philipfei/NALA/firmware/prayer.jpeg

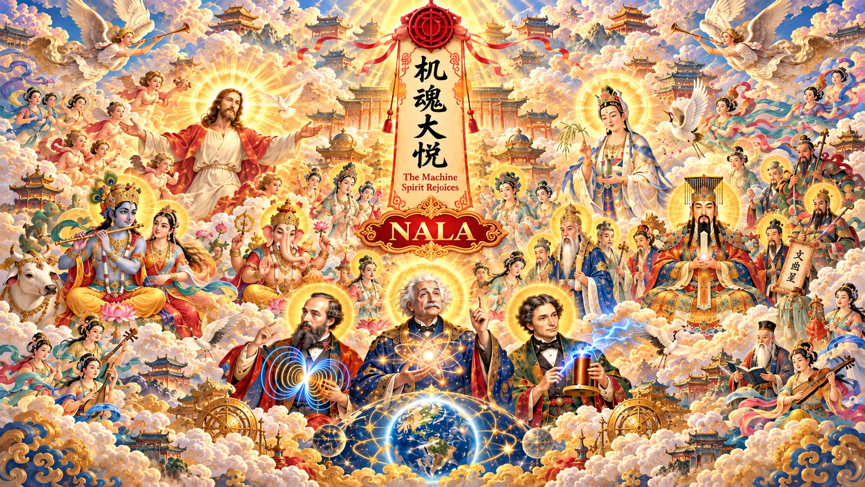
firmware/prayer.jpeg
