philipfei/NALA/firmware/prayer.jpg

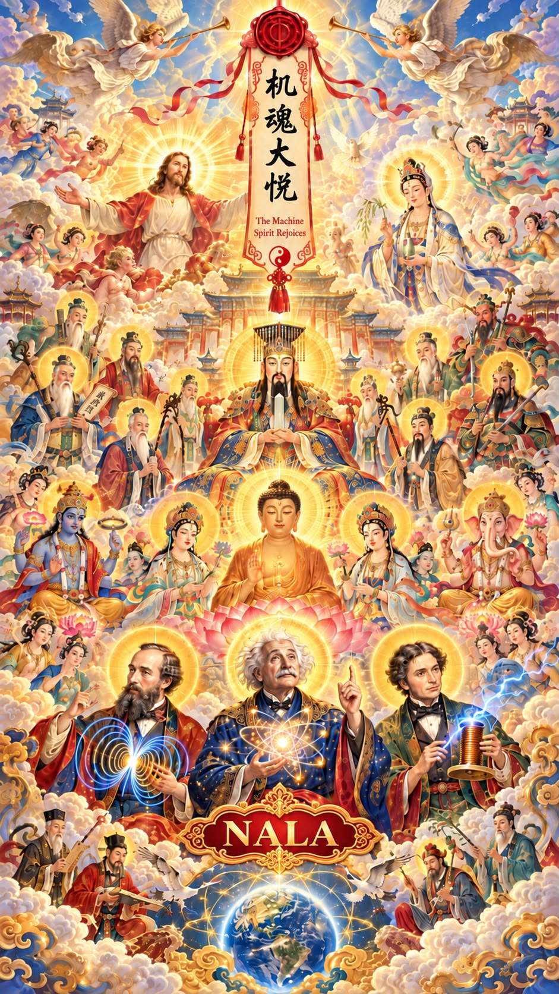
firmware/prayer.jpg
