philipfei/NALA/src/nala_base/nala_base/kinematics.py

"""Mecanum chassis math (no ROS): wheel speed limit and odometry."""

import math

from nala_base.mcu_protocol import SCALE


def raise_wheel_speed(vx, vy, wz, k, min_wheel_speed):
    """Raise a slow body speed command so that its fastest wheel is at least min_wheel_speed.

    The mirror of limit_wheel_speed: vx, vy and wz are scaled up by the same factor, so the
    direction is kept. Reason: a stalled wheel gets at most FF + kp x target + i_limit PWM in
    the firmware, so a slow target can leave a wheel standing (most often turning on the spot).
    A command that is zero in the MCU protocol (all values round to 0 mm/s, 0 mrad/s) stays
    exactly zero, so float noise never starts the robot.
    k: half track width + half wheelbase (m). min_wheel_speed: wheel rim speed (m/s).
    """
    if all(round(value * SCALE) == 0 for value in (vx, vy, wz)):
        return 0.0, 0.0, 0.0
    peak = abs(vx) + abs(vy) + k * abs(wz)
    if peak < min_wheel_speed:
        scale = min_wheel_speed / peak
        vx *= scale
        vy *= scale
        wz *= scale
    return vx, vy, wz


def limit_wheel_speed(vx, vy, wz, k, max_wheel_speed):
    """Limit a body speed command so that no wheel is faster than max_wheel_speed.

    The wheel rim speeds of a mecanum base are vx +- vy +- k*wz (all 4 sign pairs),
    so the fastest wheel is |vx| + |vy| + k*|wz|. If that is too fast, vx, vy and wz are
    scaled down by the same factor: the path keeps its shape, only slower.
    k: half track width + half wheelbase (m). max_wheel_speed: wheel rim speed (m/s).
    """
    peak = abs(vx) + abs(vy) + k * abs(wz)
    if peak > max_wheel_speed:
        scale = max_wheel_speed / peak
        vx *= scale
        vy *= scale
        wz *= scale
    return vx, vy, wz


def wheels_to_body(m1, m2, m3, m4, radius, k):
    """Wheel speeds (rad/s) -> body speed (vx, vy, wz).

    Also works for movements: wheel angle changes (rad) -> body movement (dx, dy, dyaw).

    M1 front-left, M2 rear-left, M3 rear-right, M4 front-right. Positive = the wheel pushes forward.
    radius: wheel radius (m). k: half track width + half wheelbase (m).
    This is the inverse of the firmware kinematics (docs/mcu_protocol.md).
    """
    vx = radius / 4 * (m1 + m2 + m3 + m4)
    vy = radius / 4 * (-m1 + m2 - m3 + m4)
    wz = radius / (4 * k) * (-m1 - m2 + m3 + m4)
    return vx, vy, wz


def integrate_pose(x, y, yaw, vx, vy, wz, dt):
    """Move the pose (x, y, yaw) by the body speed (vx, vy, wz) for dt seconds.

    Uses the heading in the middle of the step, which is exact enough for small steps.
    """
    mid = yaw + wz * dt / 2
    x += (vx * math.cos(mid) - vy * math.sin(mid)) * dt
    y += (vx * math.sin(mid) + vy * math.cos(mid)) * dt
    yaw = math.atan2(math.sin(yaw + wz * dt), math.cos(yaw + wz * dt))
    return x, y, yaw
