philipfei/NALA/config/panel.yaml

# Touchscreen panel on the robot (nala_panel, app 3). Runs on the Pi, on the 7 inch screen (1024 x 600).
# Started by scripts/start_panel.sh (at boot, see scripts/setup_pi_screen.sh).
# Write decimal values with a point (2.0, not 2), or the node stops with a type error.
nala_panel:
  ros__parameters:
    maps_dir: maps                # map library, relative to the repo folder (app 2 saves maps there)
    fullscreen: true              # false: a normal window (on the PC)
    window_width: 1024            # px, Waveshare 7 inch HDMI LCD (C)
    window_height: 600            # px
    font_size: 13                 # pt
    button_height: 52             # px, big enough for a finger
    update_period: 0.3            # s, how often the screen shows new robot data while driving
    manual_period: 0.05           # s, how often a held arrow button sends its command (drive by hand)
    heatmap_width_m: 0.15         # m, readings are drawn this wide around the sensor track (display only; hotspots
                                  # use the exact cells)
    launch_stop_timeout: 20.0     # s, wait this long for app 3 to stop before it is killed
    preview_retry: 10.0           # s, ask app 3 for the plan check again if it has not come by then
    battery_period: 2.0           # s, the panel reads the battery voltage (INA219, config/battery.yaml) this often
    battery_samples: 10           # shown value = mean of the last readings (10 x 2 s = 20 s), so it does not jump
    hardware: true               # false: app 3 without base_node, battery, IMU, EKF and LiDAR driver (tools/sim)
