philipfei/NALA/coverage_tool/examples/map_ME_room1v4_nala.yaml

frame_id: map
map: examples/map_ME_room1v4.yaml
map_image_sha256: c2630cb1c1f60038c21bde62c76103a3ffc8df23effceb4ea6053b22c3474248
created: '2026-10-07T14:05:45'
start: [1.157, -1.875]
area_polygon: []
stats: {pattern: 'Boustrophedon cells, no wall loop (97 deg)', cost_total_s: 463.6501, cost_drive_s: 67.0491, cost_turn_s: 234.8788,
  cost_bend_s: 15.2118, edge_missed_m2: 0.0, cost_reverse_s: 100.0, cost_overlap_s: 61.7222, cost_missed_s: 0.0, sharp_turns: 78,
  hairpins: 10, overlap_m2: 22.22, missed_m2: 0.0, coverage_pct: 54.1929, coverage_of_reachable_pct: 100.0, area_m2: 17.8575,
  covered_m2: 9.6775, path_spacing_m: 1.08, overlap_pct: 10.0, regions: 1, rings: 0, loops: 0, working_length_m: 8.6359, connector_length_m: 11.4788,
  total_length_m: 20.1147, estimated_time_s: 301.9278, goals: 28, wall_segments: 0, spiral_segments: 0, lane_segments: 6,
  centre_line_segments: 6, gap_goals: 16, skipped_unreachable: 0, uncovered_reachable_cells: 0, uncovered_interior_cells: 0,
  planning_time_s: 123.1341, drive_stops: 26, drive_arcs: 11, drive_length_m: 14.5056, drive_lost_cells: 0, drive_unsafe_segments: 0,
  drive_min_arc_radius_m: 0.3242, drive_corners_planned: 110, drive_corners_kept: 49, footprint_hits: 0}
settings:
  geometry:
    robot_radius_m: 0.33
    coverage_disk_radius_m: 0.6
    sensor_offset_m: 0.26
    footprint_m:
    - [0.205, 0.18]
    - [0.205, -0.18]
    - [-0.205, -0.18]
    - [-0.205, 0.18]
    footprint_padding_m: 0.02
  spiral: {overlap_pct: 10.0, obstacle_mode: around, wall_side: right}
  strategy: {mode: auto, wall_loop_first: true}
  cost: {smooth_turn_deg: 20.0, bend_s_per_rad: 1.5, stop_penalty_s: 1.0, reverse_angle_deg: 150.0, reverse_penalty_s: 10.0,
    overlap_weight: 1.0, missed_weight: 10000.0, edge_band_m: 0.1, edge_missed_weight: 10000.0}
  planning: {max_segment_length_m: 2.0}
  motion: {linear_m_s: 0.3, angular_rad_s: 0.8}
  drive: {min_arc_radius_m: 0.2, spacing_m: 0.05, straight_deg: 1.0, max_corner_group: 8}
  optimizer: {search_time_s: 4.0, polish_time_s: 15.0, neighbours: 8}
poses:
- x: 1.157
  y: -1.875
  yaw: 2.7328
  orientation: {z: 0.979183, w: 0.202978}
  kind: transit
- x: 0.8924
  y: -1.7604
  yaw: 2.7328
  orientation: {z: 0.979183, w: 0.202978}
  kind: transit
- x: 0.857
  y: -1.725
  yaw: 2.35619
  orientation: {z: 0.92388, w: 0.382683}
  kind: aim
- x: 1.057
  y: -1.675
  yaw: 0.24498
  orientation: {z: 0.122183, w: 0.992508}
  kind: transit
- x: 1.1873
  y: -1.571
  yaw: 0.6738
  orientation: {z: 0.330564, w: 0.943784}
  kind: transit
- x: 1.207
  y: -1.525
  yaw: 1.1659
  orientation: {z: 0.550491, w: 0.834841}
  kind: aim
- x: 1.2099
  y: -1.5749
  yaw: -1.51204
  orientation: {z: -0.686031, w: 0.727572}
  kind: transit
- x: 1.207
  y: -1.525
  yaw: 1.62955
  orientation: {z: 0.727572, w: 0.686031}
  kind: aim
- x: 1.184
  y: -1.6171
  yaw: -1.81524
  orientation: {z: -0.78804, w: 0.615624}
  kind: transit
- x: 1.157
  y: -1.575
  yaw: 2.14213
  orientation: {z: 0.877712, w: 0.479188}
  kind: aim
- x: 1.1593
  y: -1.5899
  yaw: -1.41935
  orientation: {z: -0.651589, w: 0.758572}
  kind: transit
- x: 1.207
  y: -1.575
  yaw: 0.30288
  orientation: {z: 0.150864, w: 0.988554}
  kind: aim
- x: 1.057
  y: -1.975
  yaw: -1.92957
  orientation: {z: -0.821926, w: 0.569595}
  kind: transit
- x: 0.957
  y: -2.175
  yaw: -2.03444
  orientation: {z: -0.850651, w: 0.525731}
  kind: transit
- x: 0.957
  y: -2.375
  yaw: -1.5708
  orientation: {z: -0.707107, w: 0.707107}
  kind: transit
- x: 1.007
  y: -2.575
  yaw: -1.32582
  orientation: {z: -0.615412, w: 0.788205}
  kind: transit
- x: 1.157
  y: -2.725
  yaw: -0.7854
  orientation: {z: -0.382683, w: 0.92388}
  kind: transit
- x: 1.357
  y: -2.775
  yaw: -0.24498
  orientation: {z: -0.122183, w: 0.992508}
  kind: transit
- x: 1.557
  y: -2.725
  yaw: 0.24498
  orientation: {z: 0.122183, w: 0.992508}
  kind: transit
- x: 1.757
  y: -2.525
  yaw: 0.7854
  orientation: {z: 0.382683, w: 0.92388}
  kind: transit
- x: 1.807
  y: -2.475
  yaw: 0.7854
  orientation: {z: 0.382683, w: 0.92388}
  kind: fill
- x: 1.857
  y: -2.475
  yaw: 0.0
  orientation: {z: 0.0, w: 1.0}
  kind: fill
- x: 1.857
  y: -2.425
  yaw: 1.5708
  orientation: {z: 0.707107, w: 0.707107}
  kind: fill
- x: 1.907
  y: -2.375
  yaw: 0.7854
  orientation: {z: 0.382683, w: 0.92388}
  kind: fill
- x: 1.9333
  y: -2.319
  yaw: 1.13164
  orientation: {z: 0.536108, w: 0.84415}
  kind: transit
- x: 1.957
  y: -2.275
  yaw: 1.07685
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
  - [0.107, -3.925]
  - [0.057, -3.975]
- kind: aim
  points:
  - [-0.0195, -4.2191]
  - [-0.043, -4.175]
- kind: aim
  points:
  - [-0.016, -4.1171]
  - [-0.043, -4.075]
- kind: lane
  points:
  - [0.0288, -3.8722]
  - [0.0784, -4.2943]
base_station: {x: 1.157, y: -1.875, yaw: 0.0}
