philipfei/NALA/(commit log)

2026-10-06 Set up project structure and docs (stage 0)
    - Plan the full file tree: 4 ROS 2 packages (nala_description, nala_base,
    nala_bringup, nala_coverage), firmware/, docs/, scripts/, maps/.
    Planned source files are empty placeholders.
    - Copy the MCU firmware baseline unchanged from ref/motor_driver.
    - Document the Pi <-> MCU protocol and known firmware issues.
    - Add project rules to CLAUDE.md, plus README.md and requirements.yaml.
    [motor_driver_C.componentinfo.xml]
2026-10-06 Replaced all MCU firmware
    [ADC.c, ADC.h, USART.c, Usart.h, config.h, encoder.c, encoder.h, main.c]
2026-10-06 Stage 1: keyboard teleop base driver and central config folder
    - nala_base: /cmd_vel -> MCU velocity frames (scale 0.02, ROS axes) at 10 Hz,
    speed limits, /cmd_vel timeout, parse MCU feedback lines. Unit tests.
    - nala_bringup: app1_teleop_pi launch, installs the repo config/ folder.
    - config/: base driver and teleop settings, ROS env (domain 0, Cyclone DDS),
    Cyclone limited to the robot network. Placeholders moved here.
    - scripts/setup_pi.sh: one-time Pi setup (ROS, Cyclone, UART, bashrc).
    - Docs: protocol summary for firmware v0.1.0, README app 1 commands,
    CLAUDE.md rules and facts, requirements.yaml.
2026-10-07 App 1: Xbox controller, fixed teleop speeds (1.0 m/s), 20 Hz commands
    - New package nala_teleop: PC keyboard teleop with the same IJKL keys,
    but no speed keys. Speeds come only from config/teleop.yaml.
    - Xbox controller on the Pi (joy + teleop_twist_joy): hold LB to drive,
    left stick = drive and strafe, right stick = turn.
    - Speeds 1.0 m/s and 1.0 rad/s (keys, full stick, Pi limit).
    - nala_base sends to the MCU at 20 Hz (feedback stays 10 Hz).
    - setup_pi.sh: joy, teleop_twist_joy, user in group input.
    - The repo is on ext4 now, so the PC builds the workspace again.
    [base.yaml, teleop.yaml]
2026-10-07 setup_pi.sh: install the stage 2 packages (LiDAR, URDF, SLAM, map saver)
2026-10-07 firmware: NALA_v1 - 20 Hz control, PI speed controller, M2/M3 polarity, 200 ms timeout
    Replace the firmware/ tree with NALA_v1 (built on NALA_v0).
    - Speed controller: replace the v0 incremental PID (double integrator, int
    truncation, integral kept after stop - rings for a long time) with a
    positional PI + feed-forward + anti-windup. Gains Kp 1.0 / Ki 8 chosen by
    simulation over an assumed motor model (tests/pid_sim.py); NOT tuned on
    the robot yet.
    - Timing: control period 100 -> 50 ms (20 Hz, Timer3 OCR3A = 12499).
    Feedback line stays at 10 Hz (a 6-decimal line takes ~52 ms at 9600 baud,
    so 20 Hz would not fit); same text format as before.
    - Command timeout 500 -> 200 ms: robot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
    [config.h, main.c, motor_functions.c, motor_functions.h, motor_polarity_model_test.py, pid_sim.py, timeout_model_test.py, timer.c]
2026-10-07 Docs: sync with firmware v1.0.0 (20 Hz control, 200 ms timeout, coast stop)
2026-10-07 App 2: wheel odometry, robot model, LiDAR, SLAM, RViz, save map
    - nala_base: /odom and TF odom -> base_footprint from the measured wheel
    speeds (each line integrated over the measured time; UART polled at 100 Hz).
    - nala_description: URDF base_footprint -> base_link -> laser, numbers from
    config/robot.yaml (LiDAR height is a placeholder, not measured).
    - config/rplidar.yaml: A2M8, 115200 baud, Sensitivity mode.
    - config/slam_mapping.yaml: slam_toolbox async mapping with start values
    against pose jumps (small search windows, strict loop closure, Huber loss).
    - app2_slam_pi / app2_slam_pc launch files, rviz/slam.rviz.
    - scripts/save_map.sh: occupancy grid and slam_toolbox pose graph.
    Co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
    [nala.urdf.xacro, robot.yaml]
2026-10-07 nala_base: read the UART in a blocking thread instead of a 100 Hz timer (30 % CPU on the Pi)
2026-10-07 teleop.yaml: Xbox LB is button 4, right stick X is axis 3 (checked on the Pi)
2026-10-07 CLAUDE.md: LiDAR direction and Xbox button mapping checked on the robot
2026-10-07 nala_base: limit the fastest wheel instead of the body speed
    Strafe + turn at full stick lost the turn: the firmware clips each wheel at
    100 % PWM on its own, so only two wheels slowed down. Now the Pi keeps the
    fastest wheel (|vx| + |vy| + k*|wz|) below max_wheel_speed and scales vx, vy,
    wz together. The body limits max_linear_speed / max_angular_speed are removed;
    input speeds stay in teleop.yaml. max_wheel_speed is 2.5 (no limit) until the
    motor top speed is measured.
2026-10-07 Unreversed motor polarity
2026-10-07 base.yaml: max_wheel_speed 0.45 m/s from the measured motor top speed (0.50-0.52 m/s)
2026-10-07 teleop.yaml: linear speed 0.45 m/s (keys and full stick) = the motor limit
2026-10-07 Firmware v1.1.0: encoder counts feedback (20 Hz), 38400 baud, feed-forward 6.5
    From the robot measurements of 2026-10-07:
    - The MCU now sends the cumulative encoder counts of M1..M4 every control
    period ("c n1 n2 n3 n4", 20 Hz). v1.0.x sent the speed of only every 2nd
    period, so half of the counts were never reported. The Pi odometry now uses
    the count changes: a dropped line loses no distance.
    - UART 9600 -> 38400 baud (UBRR 25, +0.16 %): a line takes ~7 ms, not ~48 ms.
    - Feed-forward 4.0 -> 6.5 %/(rad/s): 100 % PWM gives only ~13 rad/s, and with
    4.0 the integral sat at its 25 % limit.
    Pi side in the same commit: parse_line reads the counts lines, count_delta
    (int32 wrap-safe), bas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
2026-10-07 Firmware v1.1.1: feed-forward from a measured speed -> PWM table
    Step tests with v1.1.0 (wheels in the air, 0.05-0.45 m/s) showed that the
    motor curve is not linear: no motion below ~8 %, 15 % -> 3.5 rad/s,
    30 % -> 8 rad/s, 100 % -> 13 rad/s. The single factor 6.5 overshot by
    30-90 % and settled only after ~2.5 s. The feed-forward is now a 10-point
    table (FF_SPEED_RAD_S, FF_PWM_PCT in config.h) with linear interpolation.
    Protocol unchanged. Not compiled here (no avr-gcc on the PC).
    v1.1.0 is checked on the robot: counts at 20 Hz, odometry 1.10 m = tape.
2026-10-08 App 3: coverage with Nav2 and a touchscreen panel on the robot
    - nala_coverage: coverage supervisor (Nav2 ComputePathToPose + FollowPath, forward only,
    detours around obstacles, return to the base station), coverage meter, velocity gate
    (only /cmd_vel publisher in app 3), base station file and checks.
    - nala_panel: PyQt5 panel for the 7 inch robot screen. Choose a map from app 2, set the
    base station, plan from the base station or another start point (optional area),
    choose a saved plan, Start / Pause / Resume / Cancel / STOP, drive by hand while paused.
    - coverage_tool: coverage path planner (no ROS); robot outline from config/robot.yaml.
    - config: coverage.yaml, nav2_params.yaml, l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
2026-10-09 Firmware v2.0.0 (I2C link), WT901 IMU and EKF in app 2
    Hardware change (2026-10-09): the MCU now talks to the Pi over I2C
    (GPIO2/3, level shifter, MCU TWI0 PC4/PC5, address 0x10); the Pi UART on
    GPIO14/15 belongs to the new IMU (WT901C-TTL).
    Firmware v2.0.0:
    - I2C slave. Command 0x01 + vx, vy, w (int16 mm/s, mrad/s) + CRC-8;
    state frame seq, flags, 4 x int32 cumulative counts + CRC-8.
    - The TWI ISR does no computation (Pi 4 clock stretching): the main loop
    builds the state frame in a double buffer and checks the command CRC.
    - UART only for debug text. Compile check pending (on the Pi).
    Pi:
    - base_node: smbus2, write and read as two transfers, kernel I2C timeout,
    OSError and CRC erro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
    [nala.urdf.xacro, robot.yaml]
2026-10-09 setup_pi.sh: join group i2c only if it exists (Ubuntu: /dev/i2c-1 is group dialout)
2026-10-09 CLAUDE.md: IMU, UART switch and EKF checked on the Pi; gyro bias measured
2026-10-12 Track CLAUDE.md again; ignore the local IMU example folder
2026-10-12 Firmware v2.1.0 (UART binary frames), IMU on USB, INA260 battery monitor, handover
    The I2C link of v2.0.0 could never work: the level shifter on the board is
    a TXB type (the schematic says TXS0104E), and a TXB cannot do I2C.
    - Firmware v2.1.0: UART (PD0/PD1, 38400) again, with binary frames that keep
    the v2.0.0 contents: 0xA5, id, data, CRC-8. Command: vx, vy, w as int16
    (mm/s, mrad/s). State every 50 ms: seq, flags, 4 x int32 cumulative counts.
    RX state machine IDLE -> HEADER_ACK -> PAYLOAD. No text on the UART.
    NOT compiled with avr-gcc and NOT flashed (Pi and MCU were off); main.c
    passes a host gcc syntax check with stub headers.
    - nala_base: mcu_protocol and base_node for the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
2026-10-14 Phase B: IMU and LiDAR checked; INA260 address 0x4F, not answering yet
2026-10-14 MCU UART link with firmware v2.1.0 checked on the robot (frames, commands, /odom)
2026-10-14 UART wiring note, UART bench test tools, local rules moved to CLAUDE.local.md
    - firmware/README.md: UART wiring note (pin order differs on the three connectors,
    breakout TX/RX labels are from the Pi's view, P1 3.3 V feeds the level shifter)
    - Add firmware/arduino_uart_test (Arduino listener, MCU TX test, short README)
    - .gitignore: ignore CLAUDE.local.md and the local PDF in arduino_uart_test
2026-10-15 Firmware v2.2.0: setting mode for the speed controller, EEPROM, target ramp; tune_motors.py
    Motor test with v2.1.0 (wheels in the air): signs correct; 25-30 % overshoot at 3.75 rad/s,
    late start and stick-slip at 1.25 rad/s. Every gain change needed a reflash.
    Firmware v2.2.0 (compile-checked on the Pi, not flashed):
    - Parameter request 0xA5 0x03 op idx float32 crc (9 bytes, like a command) and reply
    0xA5 0x04 op idx status float32 crc: get / set / save / defaults / reload of kp, ki,
    i_limit, accel_limit and the feed-forward table. Every op except get only while stopped.
    - EEPROM block with layout version and CRC-16 (XMODEM), loaded at power-up.
    - NaN/Inf and out-of-range values are ref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
2026-10-15 Pi core clock 500 MHz (250 flooded the SD card with vc4 warnings); motor test results
    - setup_pi.sh: core_freq=500 + core_freq_min=500 instead of core_freq=250. The Pi 4 display
    driver needs at least 500 MHz; with 250 every screen update logged kernel warnings
    (~3 GB/day, the SD card was 99 % full). Still a fixed clock for the mini UART (Bluetooth).
    - CLAUDE.md, handover: wheel directions confirmed, battery 16.1 V, motor supply 12 V DC-DC,
    dead zone 11.6-13.6 %, M3 sticks after the M2 fix.
2026-10-15 Motor test without wheels: motor gains differ up to 2x, the shared FF table overshoots
2026-10-15 Motor steady-state test (3 s settle): the gain differences between the motors are real
2026-10-15 Firmware v2.3.0: one feed-forward PWM row per motor; tune_motors ff measures each motor in steady state
    The steady-state test (no wheels, 3 s settle, 2 s measured) showed that the motors differ:
    for 5 rad/s M1 needs 17.3 %, M2 14.5 %, M3 13.6 %, M4 19.9 % PWM. One shared row made the
    strong motors overshoot by 40-83 % at 0.05 m/s.
    Firmware (compile-checked on the Pi, 0 warnings; not flashed):
    - ff_m1_pwm0..9 .. ff_m4_pwm0..9 (parameters 14-53) replace ff_pwm0..9; ff_speed0..9 shared.
    - 54 parameters, EEPROM layout version 2 (a v2.2.0 block is ignored). Defaults: the old row
    for all four motors, so nothing changes until the rows are set.
    - mcu_protocol.PARAM_NAMES with the per-motor r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
2026-10-15 v2.3.0 on the robot: per-motor FF rows measured without wheels, overshoot causes found
2026-10-15 tune_motors.py ff --floor: each speed forward and back, legs <= 1.5 m
2026-10-15 Speed control tuned on the floor and saved in the MCU EEPROM; the same values as config.h defaults (v2.3.1)
    kp 2, ki 8, i_limit 10, accel_limit 0; speed points 0, 1, 2, 3.5, 5, 6.6, 8.1, 9.4, 11.5, 13 rad/s;
    one PWM row per motor = floor load + half of that motor's difference measured in the air.
    Floor steps: 5-23 % overshoot at 0.20-0.30 m/s, 18-50 % at 0.05-0.10 m/s (defaults: up to 77 %).
    v2.3.1 changes only the defaults (compile-checked); the MCU keeps running v2.3.0 with the same
    values in its EEPROM.
2026-10-16 Driving test on the floor: forward and strafe odometry exact, wheel turn rate 10-14 % too high, stop with 0.1 m/s^2 deceleration
2026-10-16 Teleop turn speed 0.5 rad/s (was 1.0); IMU yaw and first SLAM map checked, save_map works
2026-10-16 App 3: adapt to the current main (EKF, UART protocol, Ubuntu Desktop, measured accel)
    - app3_coverage_pi.launch.py: base_node without TF, battery_node, imu_node and
    the EKF like app 2 (the wheel turn rate is 10-14 % too high).
    - coverage.yaml: accel limits from the floor test (0.1 m/s^2, 0.35 rad/s^2);
    nav2_params.yaml: RPP max_angular_accel 0.35 too. Speed steps are 1 mm/s now.
    - fake_nala.py: to_int16 / SCALE (to_count was removed from nala_base).
    - setup_pi_screen.sh: keep GNOME (no Xfce/LightDM); GNOME autostart for the
    panel and the new screen_always_on.sh (gsettings). start_panel.sh: PyQt5 on
    XWayland, waits up to 10 s for the X display, finds it over SSH.
    - Docs: README, CLAUD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
2026-10-16 App 3: the Xbox B button pauses the coverage task
    app3_coverage_pi.launch.py starts joy_node and the new xbox_pause node
    (hardware only). On the B rising edge it calls /coverage/pause with
    call_async: no waiting in callbacks, no service = warning only, at most one
    open request, a short /joy message counts as not pressed. It never publishes
    /cmd_vel, so the velocity gate stays the only driver. Button index in
    config/teleop.yaml (pause_button: 1). Unit and loopback ROS tests.
2026-10-16 Simulation on Cyclone DDS (like the robot), loopback only
    tools/sim/env.sh uses rmw_cyclonedds_cpp with the new cyclonedds_sim.xml:
    lo only, no multicast, unicast discovery to localhost, ParticipantIndex auto
    with room for 50 processes (the default limit of 10 is too small for app 3 +
    fake robot), MaxMessageSize 65500B and SocketReceiveBufferSize max 10MB (the
    kernel gives 8 MB on this PC). Domain 77 stays. The app 3 tests are run in
    this environment too, never in domain 0 (robot network).
2026-10-16 start_panel.sh: over SSH use the desktop session's DISPLAY and XAUTHORITY
    The Pi's GNOME has two X sockets (X0, X1) and the session uses :0, so the
    first socket is only the fallback. The values come from the user's systemd
    manager (systemctl --user show-environment). Checked on the Pi over SSH
    (dry run from stdin): DISPLAY=:0 and the .mutter-Xwaylandauth file.
2026-10-16 App 3 supervisor: scan newer than the odom TF is not a TF error
    On the robot (2026-10-16) the RPLIDAR scan arrives ~30 ms after its stamp,
    while the EKF's odom -> base_footprint TF is up to ~25 ms behind. The trust
    check looked up the laser pose at the scan stamp, got "extrapolation into the
    future" on most checks and reported TF_UNAVAILABLE, so localization never
    became trusted. Now the newest TF is used for such a scan (a few mm at
    coverage speed); a scan older than scan_age_s is still a TF error.
    New test: fake scans 30 ms newer than the TF (fails without the fix).
2026-10-16 App 3 supervisor: receive TF in parallel with the slow callbacks (2 threads)
    On the Pi 4 the supervisor's TF buffer fell up to 0.5 s behind: TF was only
    processed between its other callbacks (scan check ~10 Hz), so the pose lookup
    at now - 0.1 s failed (TF_UNAVAILABLE) and the robot never started. main()
    now spins a MultiThreadedExecutor with 2 threads: only the TF listener's
    callbacks (ReentrantCallbackGroup) run in parallel, all other callbacks stay
    in the default mutually exclusive group. The tests already spun the node like
    this, which is why they never showed it. Simulation: RETURNED_TO_BASE, 99.3 %.
2026-10-16 App 3 supervisor: scan check with a KD-tree (55 ms -> 1 ms per scan on the Pi)
    The trust check compared every scan point with every wall cell in a Python
    loop and rebuilt the wall list each time: 55 ms per scan on the Pi 4, half a
    core at 10 Hz. The node then handled scan, odom and TF late, lost trust
    (SENSOR_STALE, TF_UNAVAILABLE) right after Start and the gate stopped the
    robot (robot test 2026-10-16). Now a cKDTree of the wall cell centres, built
    once: same points, same match distance, same result, under 1 ms.
2026-10-16 Handover for the app 3 robot tests; tools/debug diagnosis scripts
    docs/handover.md rewritten for the next session: what the session of
    2026-10-16 did (merge, adaptations, Xbox nodes, four supervisor fixes), the
    robot test history with root causes, the open problem (app 3 pauses after
    ~30 cm with SAFETY_GATE_STALE: late messages on the Pi 4), suggested next
    steps, lessons, and the first prompt. tools/debug: drive recorder, scan on
    map, TF lag (the scripts used in the tests).
2026-10-16 App 3 velocity gate: no TF listener (it never looks up a transform)
    Profile on the Pi 4 (app 3 idle, 2026-10-16): the gate used ~53 % CPU and the
    supervisor ~77 %, almost all in the rclpy executor (wait set rebuild and
    message decoding per wake-up), not in our code. Inputs always created a TF
    listener, so the gate woke up for every /tf message (~45/s) without using
    any of them. Inputs(node, tf=False) for the gate.
2026-10-16 App 3 supervisor: TF listener on its own small node and thread
    Pi 4 profile (2026-10-16): the supervisor used ~80 % CPU while idle, mostly
    in the rclpy executor; every /tf message (~45/s) woke up its big wait set
    (~30 subscriptions, services, action clients, timers). Inputs now creates
    the TF listener with tf2's own node and thread (node=None, spin_thread=True),
    so /tf no longer wakes the supervisor node and still is not delayed by its
    slow callbacks. This replaces the 2-thread executor in main(). Inputs.close()
    stops the listener thread at exit (it is not a daemon thread).
    Simulation: RETURNED_TO_BASE, 99.4 %; tests 115/115.
2026-10-16 Handover: run 8 covered 98.9 %; dimension change, corner stops, unreachable target
    docs/handover.md: CPU fixes and their measurements, run 8 in detail (task
    events, planner/controller errors, recording analysis), new open problems:
    A the changed robot dimensions (user: body 415 mm, 235 mm rod in front, 650 mm
    total, turning centre not at the outline centre; "335 mm" conflict), B long
    stops at corners (RPP limits turn-in-place to 0.0175 rad/s from standstill),
    C an unreachable last plan target; updated first prompt. CLAUDE.md: stage,
    hardware row and open questions.
2026-10-16 Handover: wheelbase is 335 mm (user); track 320 mm and width 360 mm unchanged
    The odometry scale check stays valid (rear-wheel travel). The turn arm is
    really 0.3275 m, the code and firmware still use 0.290 m: wheel odometry
    over-reports turns by 12.9 % (likely most of the "10-14 % too high" of the
    floor test) and turns are driven ~11 % slow. Not changed yet: base.yaml and
    firmware config.h must change together, then repeat the 360 deg turn test.
2026-10-16 Handover: the body is centred on the wheel centre (user); rod tip at x = +0.4425 m
2026-10-19 App 3: robot screen scan GUI, scintillator heatmap, avoid contamination, go home
    - nala_interfaces: CountRate message; /scintillator/count_rate is the scintillator input
    (USB format unknown, no driver yet; docs/scintillator.md).
    - radiation_node (nala_coverage): background measured on the base station at the start,
    readings painted only at trusted measured poses, hotspots (2x background), keepout zone,
    readings.csv / hotspots.json / heatmap.npz in the run folder.
    - Supervisor: BACKGROUND state before any motion (NO_SCINTILLATOR pause), skips plan stretches
    in contaminated floor (CONTAMINATION_AVOIDED), /coverage/go_home. Nav2 global costmap has a
    keepout layer (high cost, not a wal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
2026-10-19 App 3: show map changes on the robot screen (new objects, gone objects)
    - mapchange.py / mapchange_node (nala_coverage): LiDAR scans at trusted poses are compared
    with the saved map. New object = free map cell the beams keep ending in; gone = map obstacle
    the beams keep passing through with no beam ending near it. Counted once per scan, with a
    margin along the map's walls against small pose errors. /map_changes, changes.npz per run.
    - Panel: new objects orange-red, gone objects light blue, a Changes layer toggle, "Map changed"
    area in the side panel and the Results tab.
    - Checked in the simulator with a box that is not in the map: 8 new cells, all at the box,
    none elsewhere.
    Co-Au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
2026-10-19 App 3 UI on Friday's main: radiation off until the scintillator exists; mapchange TF on its own thread
    - radiation.enabled false: without a scintillator driver every task would wait for background
    readings and pause with NO_SCINTILLATOR, so the robot would not drive as on 2026-10-16.
    - mapchange_node: TF listener on its own small node and thread (like the supervisor since cc584a7),
    so /tf (~45/s) does not wake the node on the Pi 4; the thread is stopped at exit.
2026-10-19 Robot outline with the rod (not centred), wheelbase 335 mm, RPP turn start fix (handover A + B)
    A (user answers 2026-10-19: rod as wide as the body, below the LiDAR; sensor on the rod not known yet):
    - config/robot.yaml: outline front 0.4425 / back 0.2075 / left, right 0.18 m replaces body_length x
    body_width; read by params.py, coverage_tool/settings.py, the URDF and tools/sim/fake_nala.py.
    Farthest corner 0.478 m: collision radius 0.498 m, plan radius 0.53 m (was 0.293 / 0.33).
    - half_wheelbase 0.1675 in config/base.yaml and firmware v2.3.2 (compile-checked on the Pi, not flashed).
    - Tests use a fixed test robot (the old centred box): they check the logic, not this robot's size.
    B (use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
2026-10-19 AMCL alpha4 0.01 (was 0.05): turning on the spot no longer pushes the position sigma over the trust limit
    Robot 2026-10-19 (room Test, rod outline, RPP fix A): POSITION_UNCERTAIN pauses, AMCL sigma median 0.093 m
    (run 8: 0.042), growing ~1 cm per second of turning on the spot. The LiDAR is at the turning centre and the
    heading comes from the IMU. Simulation room Test: RETURNED_TO_BASE, 99.8 %, sigma median 0.038 m, AMCL error
    0.039 m (0.047 with alpha4 0.05), 0 contacts. Config tests pass.
2026-10-19 Turn start in the velocity gate, AMCL alpha1 0.02, map changes node slower, scan side panel fits 600 px
    Robot run 2026-10-19 11:21 (room Test): HEADING_UNCERTAIN after turns, one 14 s stall at 0.15 rad/s,
    Nav2 controller and EKF missing their rates (CPU), and the scan screen had to scroll on the Pi.
    - Velocity gate: a Nav2 turn on the spot (no forward speed) asks at least motion.turn_start_rad_s 0.3,
    still ramped at 0.35 rad/s^2; RPP max_angular_accel back to 0.35 (user decision).
    - AMCL alpha1 0.05 -> 0.02: the heading comes from the IMU gyro (user decision).
    - map_changes scan_period_s 0.5 -> 2.0, beam_step 2 -> 4 (CPU on the Pi).
    - Scan screen side panel: tighter gaps instead of the scr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
2026-10-19 Locator: app 3 finds the robot on the map from the LiDAR scan; Start only on the base station
    User requirement 2026-10-19: app 3 must not assume the robot starts on the base station, must show the real
    position, say "Robot is not on the base station" instead of a scan mismatch, and let the user put it there.
    - locate.py (no ROS): whole-map scan search and the base station check (ON_BASE / BACKWARDS / NOT_ON_BASE;
    room Test is almost symmetric around the base station, so "backwards" is checked explicitly).
    - locator_node: /scan -> /coverage/located every 2 s while no task drives (settings `locator`).
    - Supervisor: Start needs ON_BASE (NOT_ON_BASE_STATION / ROBOT_BACKWARDS / LOCATOR_UNAVAILA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
2026-10-19 Robot turned on the base station: say how far to turn; base station shows outline and heading
    Robot 2026-10-19: on the base station position but turned 132 deg, the screen only said 'not on the base
    station'. New locator status TURNED with turn_deg ('Turn it about 132 degrees to the left'), refused at Start
    (ROBOT_TURNED). The map draws the robot outline (body + rod, dashed) and a clear arrow at the base station
    (user: show the required heading; the old dark arrow on a dark square could not be seen). Tests 143 + new
    checks pass.
2026-10-19 Turns: gate lift only from standstill, RPP turn accel back to 3.0; trust: the scan decides
    Robot 2026-10-19 13:25: 13 POSITION_UNCERTAIN pauses in turns and turns that are not in the plan. Simulation:
    with the always-on lift and RPP 0.35 the robot turned 1500-2700 deg on the spot per run instead of ~900.
    - Velocity gate: a Nav2 turn on the spot is lifted to turn_start only while the robot stands; once it turns,
    Nav2's own command passes (ramped), so it can slow down at the heading.
    - RPP max_angular_accel 3.0 again (0.35 could neither start a turn nor slow down in time).
    - Trust (user decision): AMCL sigma over the limit pauses only when the live scan does not fit the map or the
    sigma is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
2026-10-19 Wheelbase 340 mm and flashed (firmware v2.3.3)
    Daniel measured the wheelbase again: 340 mm (v2.3.2 had 335 mm).
    Half wheelbase is 0.170 m, so the rotation arm k is 0.330 m.
    config/base.yaml and firmware config.h must match. v2.3.3 is flashed by
    the user; v2.3.2 was never flashed. Docs updated (firmware README,
    mcu_protocol, handover). Still to do: repeat the 360 deg turn test.
2026-10-19 Escape from a start a little too close to a wall; "Recalculating..." on the driving screen
    Robot 2026-10-19 14:37: after driving around a box the robot stood 2-3 cm closer to a wall than the collision
    radius: EXECUTION_CHECK (start check needed a safe straight line from an unsafe start) and NavFn failed to plan
    from inside its band -> BLOCKED_IN_PLACE.
    - Grid.escape_start: from a start inside the band, the nearest safe point within planner_start_tolerance_m in
    sight. The start check uses it; plan_to plans from that point (use_start) and follow() accepts the short
    first segment out.
    - Screen (user): a pause that resumes by itself keeps the driving view and says "Recalculating..."; Pause t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
2026-10-19 Planner covers a corner when the robot is there; no zoom buttons on the map screen
    User 2026-10-19: the route went back to a corner it had already driven through.
    - coverage_tool LocalSearch: aimed goals are also offered at the ends of route pieces (turn on the spot there,
    any heading in 5 deg steps), and reaim() re-places every aimed goal after the route is ordered (kept only if
    cheaper). Room Test: planned 77 s instead of 87 s, every corner covered once, 100 % of the reachable floor,
    0 outline hits, 0 unsafe segments, 0 lost cells; plan maps/Test/plans/2026-10-19_151921 passes the robot's checks.
    - Map screen: the +, - and o zoom buttons are gone (they did not work on the robot; pinc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
2026-10-19 Plan check: no endless restart near the base station, reachable floor 150x faster, result saved per plan
    User 2026-10-19: "Checking the plan" took long in room Test. Cause: AMCL was compared with the base station pose
    (10 cm / 10 deg) while the locator accepts 15 cm / 15 deg: a robot put 10-15 cm off made AMCL restart every 2 s
    (38x "initial pose" in drive 12), and each restart dropped the plan check.
    - Supervisor: AMCL restarts only when it differs from where the locator sees the robot (locator tolerance), and
    then starts there.
    - Grid.reachable: connected areas of the safe cells (scipy) instead of a Python flood fill: identical result on
    room Test and the example maps, ~150x faster (Pi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
2026-10-19 One continuous turn per corner instead of a Nav2 goal per aim
    User 2026-10-19: corners took long (drive to the corner, stand, then sweep). Each 5 cm aim was its own Nav2
    goal: stop, hand-over, a new slow start of the turn, 3-4 times per corner.
    - plan_file.merge_turns: pieces up to planning.turn_merge_length_m (0.06 m) become, with the stop before
    them, one 'turn' target with the headings to turn through.
    - Supervisor TURN state: turns on the spot itself through those headings (via /cmd_vel_nav and the velocity
    gate, which ramps and limits it), slowing only before the last heading in the same direction; within
    motion.turn_tolerance_deg a heading counts as reached; a turn that does not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
2026-10-19 Robot screen: start app 1 (drive) and app 2 (make a map, save it with an on-screen keyboard)
    User 2026-10-19: apps 1 and 2 should start from buttons on the robot screen.
    - nala_panel/apps.py: AppSession starts/stops app1_teleop_pi / app2_slam_pi.launch.py like app 3 (Ctrl-C,
    killed after launch_stop_timeout, log in log/), refuses to start while another app's nodes run, receives
    app 2's live /map and the robot pose (own TF thread), saves the map with scripts/save_map.sh; map names:
    1-40 letters/digits/-/_, never an existing map.
    - ui: "Drive (app 1)" and "Make a map (app 2)" on the map list; AppScreen with status (motor driver
    connected), Xbox instructions, STOP / Start / Back; app 2: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
2026-10-20 No turn for a few-cm step between lanes: plans export the kind of each drive path point
    User 2026-10-20: an odd turn along a straight wall. In room Test the bottom lane has two parts 5 cm apart
    (y -1.13 and -1.18); the 5 cm step became a turn south and back (merge_turns treated every short piece as a
    corner sweep), covering nothing (0 cells).
    - coverage_tool export: drive_path 'kinds' (the planner's kind of the stretch arriving at each point).
    - plan_file: pieces carry their kinds; merge_turns turns only for short 'aim' pieces (corner sweeps); another
    short piece is skipped and the robot drives on to the next one. Plans without kinds work as before.
    New plan for room Test with kinds: same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
2026-10-20 A few-cm step between lane parts joins them into one piece: no stop, no turn
    Robot 2026-10-20 (drive 14): after the turn fix the robot still stopped and made a small turn where the bottom
    lane of room Test steps 5 cm aside (the map's south wall is a pixel staircase; the real wall is straight): the
    two lane parts were still separate Nav2 goals.
    - plan_file.merge_turns: a short non-sweep step joins the piece before, the step and the piece after into one
    piece of the planner's own stretches; Nav2 follows it in one go (5 cm aside over its 0.2 m lookahead is a 14 deg
    correction, below the 20 deg turn-on-the-spot angle). Room Test: the whole bottom lane is one piece.
    Tests: 155/155.
    Co-Author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
2026-10-20 Scan screen: "Show map" stays until "Big view"; corner turns count as driving on the screen
    User 2026-10-20: the screen should switch to the driving view by itself, but after "Show map" it must not
    switch back by itself. The choice was reset whenever the task was not driving (a pause, a state change); now
    only "Big view" or a new scan resets it. The screen and the drive session also did not know the TURN state
    (corner turns, 2026-10-19): during a corner turn the screen counted as not driving and Pause was disabled.
    Tests: panel 23/23.
2026-10-20 Rejoin the plan while driving after a pause beside it, instead of a planned connection
    Robot 2026-10-20 (drive 15, north-west corner): after a corner turn AMCL corrected the pose by ~11 cm; after the
    auto-resume the robot was 12-16 cm beside the lane, so the supervisor planned a connection to the rest of the
    lane (turn on the spot, drive, turn on the spot). AMCL lost certainty in those turns: 35 s of pauses on one spot.
    User: reconnect to the actual path smoothly, without turning on the spot too much.
    - Supervisor.rejoin: up to planning.rejoin_max_m (0.3 m) beside the piece, one path straight from the robot to
    the point rejoin_ahead_m (0.4 m) further along it, then the piece; Nav2 drives b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
2026-10-20 Rejoin: beside the last few cm of a piece, go on to the next instead of driving there
    Robot 2026-10-20 (north-west corner of room Test): after a pause ~15 cm beside the end of the lane, the rejoin
    point was the lane's end point a few cm away at a steep angle, so Nav2 turned on the spot first (right to 49 deg),
    before the planned corner sweep. Now, when less than rejoin_ahead_m of the piece is left and the robot is within
    rejoin_max_m of its end, the piece counts as done (REJOINED_AT_END) and the next one (the corner turn) follows.
    Tests: the fake FollowPath server now stops on cancel, like Nav2; new test; 157/157.
2026-10-20 Results tab: scroll through every previous scan and show the chosen one on the map
    User 2026-10-20: only the last scan was visible. library.list_runs lists every run folder of a map with a task
    or coverage report, newest first (date, % covered, how it ended); load_run loads one: heatmap, keepout,
    hotspots, actual trail, covered floor, map changes. The Results tab has the scrollable list (drag to scroll on
    the touchscreen); the chosen scan is drawn on the map, including the covered floor (runs without scintillator
    readings would otherwise look the same). Tests: panel 25/25 incl. new library and screen tests.
2026-10-20 Drive-ins: fewer turns and safer starts after the first robot drive
    Planner: merge drive-ins one drive-in can do (two into one pocket before), end
    each as shallow as its cells allow, start only where P has robot radius + 3 cm
    (the robot turns there after backing out), and cut the path end back while it
    covers nothing new (it went back across the room to the pocket mouth).
    Robot: drive straight onto a drive-in's start when Nav2 stopped more than
    spur.max_offset_m beside it (6 cm on the robot, nearly touching the box); back
    out to, not short of, P; check walls behind with the bare outline (false 'wall
    behind'); accept a piece Nav2 finished a little off its end and continue from
    there instead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
2026-10-20 Drive-ins planned by the route optimiser instead of added to a finished path
    User 2026-10-20: no post-processing of a planned path; the planner's logic must
    make the route right. Floor only a drive-in reaches now counts as floor to cover,
    and drive-in candidates (spurs.py: straight in from a start with turning room,
    the same way back out, outline-checked, only as deep as the sensor needs) are
    pieces of the route optimiser: added, dropped, moved and re-chosen in context by
    the cost function (time at the robot's half drive-in speed). The merge / trim /
    straighten steps are gone. Connectors bend as little as the walls allow (a few
    mm short of clearance made a 90 deg turn, 5 cm, and back), and p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
2026-10-20 Drive-ins steer on odometry, gently
    Robot 2026-10-20: the drive-in zigzagged +-15-20 deg into the pocket and the
    back-out was refused at 15 deg off (SPUR_OFF_LINE): the steering followed the
    AMCL pose, which jumps a few cm and degrees at each correction, with the strong
    gains set to pull in from 5 cm off. The line is now put into the odometry frame
    once when the drive-in starts (the back-out reuses it) and followed on odometry,
    like Nav2's controller; gains back to 1.5 / 6 (no overshoot at 0.06 m/s).
    Simulation test_basement2: heading within 3 deg in the pockets, 99.89 %, no
    contacts.
2026-10-20 Drive in like any piece of the path; only backing out is the supervisor's
    User 2026-10-20: the drive-in is a normal part of the planned path. Driving in is
    now a plan piece Nav2 follows (corner at its start like every corner; the stretch
    from P checked with the outline instead of the turning circle); only backing out
    is driven by the supervisor, on odometry. Removes the hand-over at P and its
    turn-drive-turn approach (Nav2's 5 cm point goal vs the line): the random turns
    before drive-ins on the robot. A stop inside a pocket (Nav2 failure, timeout,
    pause, contamination ahead) backs out from there (SPUR_SHORTENED).
    Planner: driving in counted at normal speed, backing out at half; the drivable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
2026-10-20 Supervisor timing log (diagnostics only)
    Robot 2026-10-20: twice SCAN_STALE / AMCL_STALE at the end of a pocket while the
    LiDAR (15 Hz, 5 ms old) and AMCL (2 Hz) were fine; the Pi had a load of 15 and
    the supervisor 53-58 % CPU. Every health.timing_log_period_s the supervisor logs
    its longest step (and the trust check in it), the longest gap between steps, how
    many AMCL / scan / odom messages it handled and the oldest age, and the load.
    No change in behaviour.
2026-10-21 Battery monitor: INA219 at 0x40, voltage only
    The battery monitor chip is now an INA219 (I2C address 0x40, IN+ and IN- shorted). It measures only the battery voltage, no current. The old INA260 never answered and is still soldered on the same I2C lines.
    - ina260.py (file name kept): INA219 bus voltage decoding, (register >> 3) x 4 mV, the two flag bits are ignored. The current decoding is removed.
    - battery_node.py: no current read, /battery_state current = NaN. The current_sign parameter is removed. Topics, imports and node name are unchanged.
    - config/battery.yaml: i2c_address 64 (0x40), current_sign removed.
    - test_ina260.py: voltage tests changed to the INA219 format.
    - docs/battery.md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
2026-10-21 Battery: INA219 at 0x40 read on the robot (16.44 V); README: read the voltage over SSH
2026-10-21 Panel: battery icon with voltage and percent on every screen
    The panel reads the INA219 itself every 2 s (battery_node runs only with app 1 or 3)
    and shows the mean of the last 10 readings, so the value does not jump.
2026-10-21 Battery: low 14.4 V (3.6 V/cell), empty 12.8 V (3.2 V/cell)
2026-10-21 Docs: battery low 14.4 V, empty 12.8 V
2026-10-21 CPU: events executor for NALA's Python nodes, cheaper meter and panel
    Robot 2026-10-20: load 15 on the Pi 4; the supervisor handled scans and AMCL poses
    too late (SCAN_STALE / AMCL_STALE). Profiling in the simulation: 75-80 % of the
    supervisor's and the velocity gate's CPU was rclpy's default executor.
    - All NALA Python nodes use rclpy's EventsExecutor (health.events_executor, false =
    the default executor): blocking spin() in a background thread; the main thread
    waits for the node's own Ctrl-C/SIGTERM flag, then the node's own shutdown steps
    (the gate's stop burst, the supervisor's lease release) run single-threaded as
    before. Every node exits cleanly in the simulation.
    - Meter: tra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
2026-10-21 Resume after a pause inside a pocket: back out
    Robot 2026-10-20: a pause inside a pocket (SCAN_STALE / AMCL_STALE) could never be
    resumed, neither automatically nor with Resume: the resume check required turning
    room, which a pocket never has. When the next thing the robot does is back out
    (paused while driving in or backing out) that check is skipped; backing out keeps
    its own checks (on its line, measured and clean floor, LiDAR clear behind).
    Nothing changes outside pockets.
2026-10-21 Back out of pockets at the normal speed; supervisor exits cleanly
    User 2026-10-21: back out at the normal driving speed. spur.speed_m_s 0.06 -> 0.12
    m/s; the LiDAR stop distance behind the robot 0.06 -> 0.10 m (braking distance at
    0.12 m/s with 0.1 m/s^2 is 0.072 m, plus a reaction step); steering track_gain 6 ->
    4.5 so it does not overshoot the line at that speed. The planner counts backing
    out at that speed (speed_factor 1.0). Simulation: back-out within 3 cm / 4.3 deg of
    the line, no contacts, 182 s instead of ~194 s.
    Supervisor: the events executor is made and freed inside run_until_stopped (freed
    while rclpy still runs), and the process ends with os._exit(0) after every
    shutdown step: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
2026-10-21 Passages: drive straight through entrances narrower than the turning circle
    User 2026-10-21: on the RDG map a room has turning room inside, but its 0.70 m
    entrance is narrower than the 1.06 m turning circle, so the planner never reached it.
    Planner (coverage_tool/coverage/passages.py): areas with turning room behind such an
    entrance are joined by straight passages that the outline (+ padding + the drive-in
    margin) drives forwards both ways. Grid.astar routes through passages between
    areas, so every connection the planner makes can use them. The drivable path marks
    them 'passage' (never rounded or cut). A route that would end inside such an area
    includes its way out (Nav2's return home canno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
2026-10-22 Planner: cost decides the wall distance per stretch (shift move), real speeds, stops cost more
    The RDG route was wobbly: many stops where lines followed the map's pixel staircase along diagonal
    walls at the safety limit. The route optimiser gets a shift move: stretches (up to 2 m) of a line at
    the limit are tried further from the wall, up to where the sensor still reaches the wall floor, as
    they are and straightened; kept only if the total cost goes down (user 2026-10-22: no fixed inset,
    the cost decides). It runs before straighten, else the time budget is used up before it is tried.
    The planner now uses the robot's speeds from config/coverage.yaml, stops cost 3 s extra, and there is
    no wall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
2026-10-22 App 3: contamination stops the robot and ends the scan; threshold set on the robot screen
    User 2026-10-22: the robot no longer drives around contamination. 2 of the last 3 scintillator
    readings at the operator's threshold (any time in a task, also without a trusted pose) stop the
    robot like a pause and end the task (FAILED, CONTAMINATION_FOUND; no resume, no driving home).
    The threshold is set on a new Settings screen (counts/s or x background, keypad), saved in
    maps/contamination_threshold.yaml and sent latched on /radiation/threshold; config/coverage.yaml
    has the defaults. The robot screen shows a full-screen red warning with the readings, threshold,
    time and sensor position until Acknowle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
2026-10-22 Fix planning that never ended; the robot screen shows the real driving time
    - Planner: the drive home now ends at the reachable cell nearest the base station. A base station a
    few mm inside the safety distance on the 5 cm grid (the panel tests' small room) made the drive home
    unreachable, every route cost 1e7 and the rebuild phase never ended. Extend and rebuild only accept
    gains of at least optimizer.rebuild_min_gain_s (tiny gains kept them going).
    - The planner writes the drive home into the plan (drive_path.home).
    - Robot screen (user 2026-10-22): the plan time is the real driving time, never the planner's cost:
    plan_file.drive_time_s from the drivable path, the motion speeds and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
2026-10-26 LiDAR moved 115 mm forward (robot.yaml laser.x 0.115)
    User 2026-10-26: the LiDAR was moved 115 mm towards the front of the robot. Every NALA node reads
    its position through TF (URDF from robot.yaml); the simulation reads robot.yaml too.
2026-10-26 LiDAR height measured: 172.5 mm above the floor (robot.yaml laser.z)
2026-10-26 Scintillator driver: USB serial -> /scintillator/count_rate
    scintillator_node (nala_base) reads the scintillator over its Prolific
    USB-serial adapter (19200 8N1, RTS/CTS, config/scintillator.yaml). One
    TAB-separated line per second; only the value before the second "cps"
    is used, stamp = Pi arrival time. Started by app 3 on the robot.
    radiation.enabled stays false until the real background and threshold
    are known (user, 2026-10-26).
2026-10-26 README: wheelbase 335 mm (half 167.5 mm), as in base.yaml and firmware v2.3.2
2026-10-26 Minimum wheel speed 0.08 m/s; coverage 0.15 m/s / 0.5 rad/s; teleop turn 0.6 rad/s
    Motors sometimes stood still on slow commands, most often when turning on the
    spot: the firmware gives a stalled wheel at most FF + kp x target + i_limit PWM
    (~25-34 % for the slow commands). base_node now scales a non-zero command up
    until its fastest wheel reaches min_wheel_speed (raise_wheel_speed, same
    direction; zero at the protocol resolution stays zero), then limits it as before.
    fake_nala does the same.
    Coverage: spur speed follows the driving speed (0.15), clear_m 0.13 (braking
    distance), track_gain 3.6 (no-overshoot rule at 0.15 m/s).
2026-10-26 LiDAR offset 95 mm (robot.yaml laser.x 0.095): the 0.115 of 2026-10-23 was wrong
2026-10-27 App 3: AMCL omni motion model, RPP speed-scaled lookahead, run analysis tool
    Analysis of the robot runs 2026-10-26 on RDG_NM_v4 (docs/handover.md):
    - 40 POSITION_UNCERTAIN pauses in 15 min, all in slow turns: the AMCL differential
    model turns a sideways odometry move (mecanum, wheel slip) into ~0.2-0.4 m of
    position noise in one update. Now nav2_amcl::OmniMotionModel, same alphas.
    - Weaving (+-8-10 deg, ~6.5 s period on straight pieces): pure pursuit with a fixed
    0.2 m lookahead and ~0.8-1 s loop delay. Now speed-scaled lookahead
    (lookahead_time 3.0 s, 0.2-0.45 m).
    - SCAN_STALE: CPU on the big map; not changed, measure in the next run.
    tools/debug/analyze_run.py summarizes a run fol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
2026-10-28 App 3: Nav2 xy_goal_tolerance 0.05 -> 0.10 m (robot turned in circles near piece ends)
    Robot run 2026-10-28: while turning on the spot, base_link moves on a ~8 cm circle
    in the AMCL pose, so RPP kept turning towards a goal ~10 cm away for up to 100 s.
    Handover: the run analysis and the NTP clock jump in the same run (not fixed yet).
